ftkalcevic/BigAziz/schematics/curved.pdf

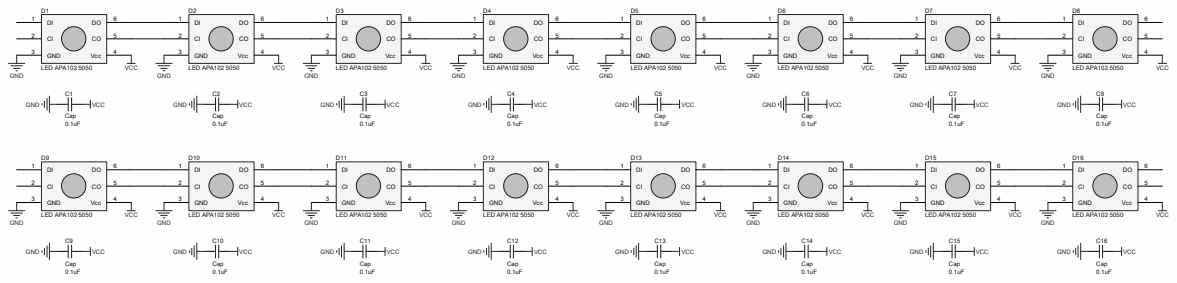
[picture p5: page 1]
