ftkalcevic/BigAziz/schematics/straight.pdf

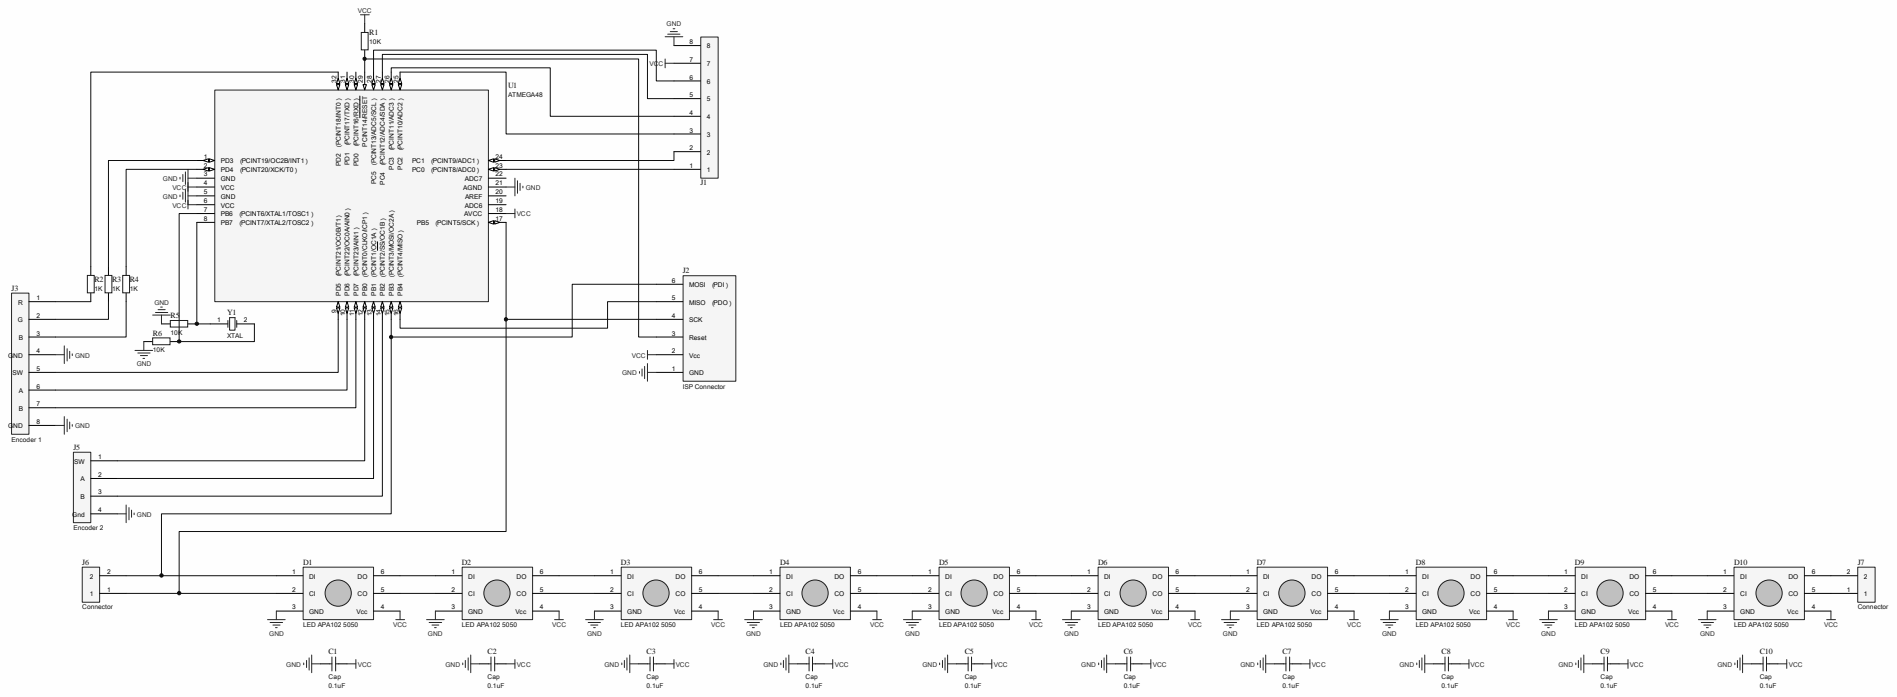
[picture p6: page 1]
